PontshoMbizo/micromouse-power-subsystem/fabrication/BOM-MM_power_subsystem.csv

Comment | Designator | Footprint | LCSC | Quantity
4.7uH | L2 | L_0201_0603Metric_Pad0.64x0.40mm_HandSolder | C1034 | 1
0.1uF | C15,C16,C18,C19,C20,C26,C27,C28 | C_0603_1608Metric_Pad1.08x0.95mm_HandSolder | C14663 | 8
MCP73831-2-OT | U3 | SOT-23-5 | C14879 | 1
1uF | C10,C11,C12,C13 | C_0603_1608Metric_Pad1.08x0.95mm_HandSolder | C15849 | 4
11k | R2 | R_0805_2012Metric_Pad1.20x1.40mm_HandSolder | C17429 | 1
15k | R8 | R_0805_2012Metric_Pad1.20x1.40mm_HandSolder | C17475 | 1
3k | R3 | R_0805_2012Metric_Pad1.20x1.40mm_HandSolder | C17661 | 1
100k | R1 | R_1206_3216Metric_Pad1.30x1.75mm_HandSolder | C17900 | 1
10k | R5 | R_1206_3216Metric_Pad1.30x1.75mm_HandSolder | C17902 | 1
2k | R4 | R_1206_3216Metric_Pad1.30x1.75mm_HandSolder | C17944 | 1
DRV8837CDSGR | U11,U12,U13,U9 | DRV8837CDSGR | C191000 | 4
1N5819WS | D2 | D_SOD-323 | C191023 | 1
4.7uF | C1,C2 | C_0603_1608Metric_Pad1.08x0.95mm_HandSolder | C19666 | 2
AO3400A | Q1 | SOT-23 | C20917 | 1
HUSB237 | U6 | HUSB237 | C22373734 | 1
75k | R10 | R_0603_1608Metric_Pad0.98x0.95mm_HandSolder | C23242 | 1
RT9742GGJ5 | U7,U8 | RT9742GGJ5 | C250547 | 2
100m | Rshunt1 | R_1206_3216Metric_Pad1.30x1.75mm_HandSolder | C25334 | 1
110k | R7 | R_0603_1608Metric_Pad0.98x0.95mm_HandSolder | C25805 | 1
SW_SPST | SW1 | MR1-110-C5N-BBAA | C268221 | 1
22uH | L1 | L_0805_2012Metric_Pad1.05x1.20mm_HandSolder | C32375 | 1
22uF | C21,C22,C23,C24,C25,C8,C9 | C_0603_1608Metric_Pad1.08x0.95mm_HandSolder | C59461 | 7
MT3608 | U4 | SOT-23-6 | C84817 | 1
INA219AIDCNR | U2 | INA219AIDCNR | C87469 | 1
MT2492 | U1 | MT2492 | C89358 | 1
TYPE-C 6Pin(073) | U10 | TYPE-C 6Pin(073) |  | 1
TestPoint | TP11 | TestPoint_Pad_D4.0mm |  | 1
TestPoint | TP6 | TestPoint_Pad_D4.0mm |  | 1
TestPoint | TP3 | TestPoint_Pad_D4.0mm |  | 1
TestPoint | TP8 | TestPoint_Pad_D4.0mm |  | 1
TestPoint | TP10 | TestPoint_Pad_D4.0mm |  | 1
TestPoint | TP2 | TestPoint_Pad_D4.0mm |  | 1
Conn_02x16_Top_Bottom |  | PinHeader_2x16_P2.54mm_Vertical |  | 0
TestPoint | TP1 | TestPoint_Pad_D4.0mm |  | 1
TestPoint | TP16 | TestPoint_Pad_D4.0mm |  | 1
TestPoint | TP4 | TestPoint_Pad_D4.0mm |  | 1
TestPoint | TP14 | TestPoint_Pad_D4.0mm |  | 1
TestPoint | TP9 | TestPoint_Pad_D4.0mm |  | 1
TestPoint | TP13 | TestPoint_Pad_D4.0mm |  | 1
TestPoint | TP5 | TestPoint_Pad_D4.0mm |  | 1
TestPoint | TP7 | TestPoint_Pad_D4.0mm |  | 1
TestPoint | TP12 | TestPoint_Pad_D4.0mm |  | 1
Conn_01x02_Socket |  | PinHeader_1x02_P2.00mm_Horizontal |  | 0
TestPoint | TP15 | TestPoint_Pad_D4.0mm |  | 1
AP2112K-3.3 | U14 | SOT-23-5 |  | 1
